popochom/ECEN404-2026SP-SolarHomeLighting1/README.md

This is a Repository that Contains the project files for a Solar-Powered Home Lighting System. 

This Repo is divided into the four main subsystems, namely:
- Charge Controller
- Power Inverter
- Sensors and Lighting Microcontroller
- Mobile App and Activity Detection Software
