popochom/ECEN404-2026SP-SolarHomeLighting1/Presentations/404/Solar Home Lighting 1 (Team 42) -  Showcase Poster.pptx

Solar Home Lighting 1
Matthew Cepulis, Corey Perlmutter, Thomas Moll, Sara Rueda
Professor Wonhyeok Jang

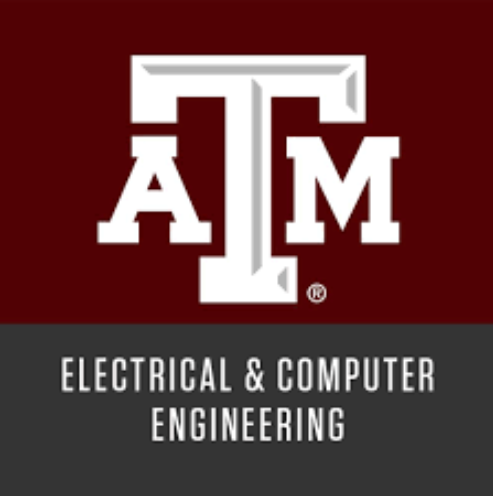
[picture p1: figure]

Problem Definition
Traditional residential lighting systems rely heavily on grid electricity, lack intelligent control features, and do not optimize for energy savings, especially for night-time usage when lighting demand is highest.

Methodology
For our project, we designed and prototyped a standalone Solar Home Lighting System that facilitates various functions. For power generation and storage, the system employs an MPPT Charge Controller to regulate the current from a solar panel to charge a 12V battery. The stored charge is then distributed to a handful of subsystems for use by the end-user, such as a 120VAC inverter for powering small electronics, a microcontroller for monitoring sensors and operating on-board lights, and a Raspberry Pi running low-light Human Detection. For monitoring and control, an app was designed that interfaces with the subsystem through a cloud database.

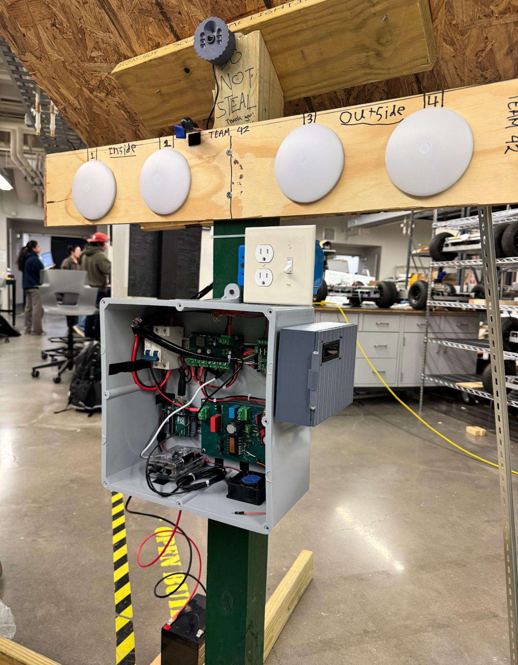
[picture p2: figure]

Figure 2. Integrated system

B

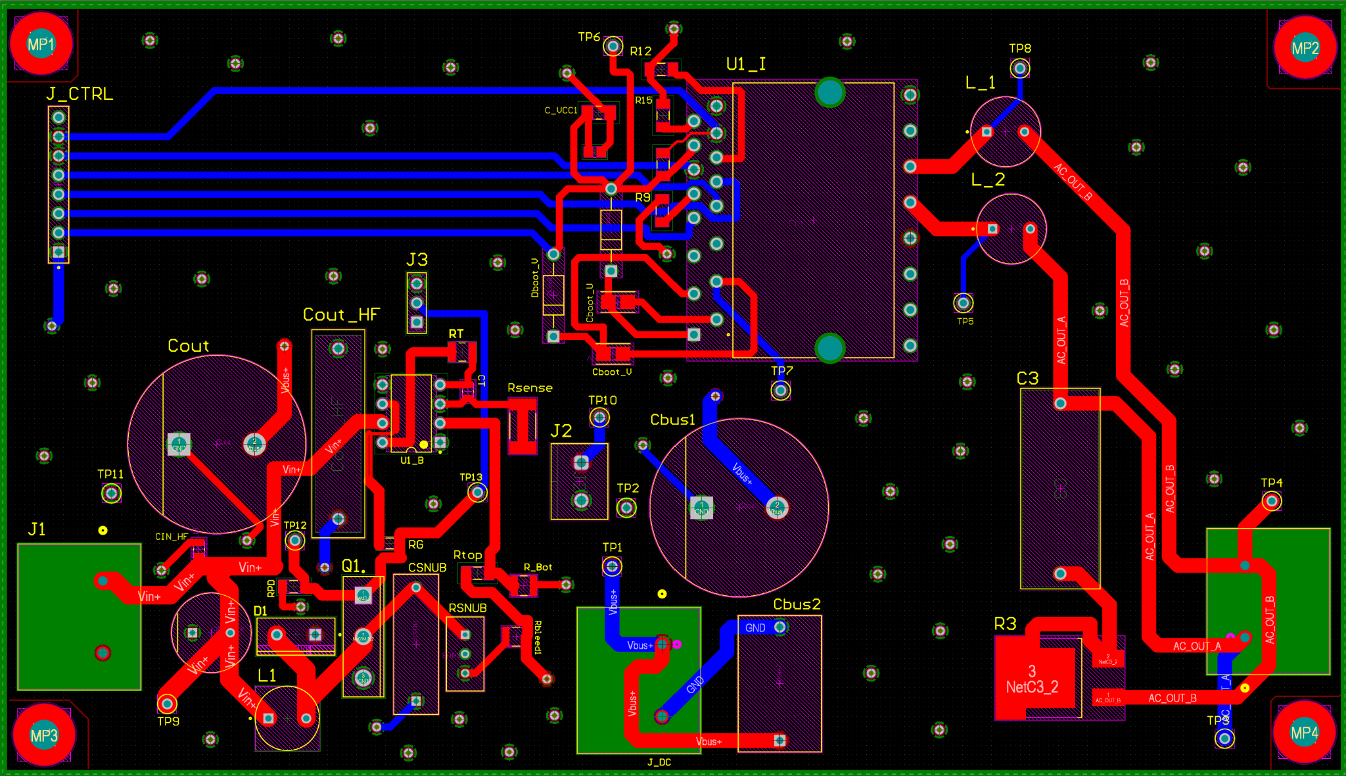
[picture p3: figure]
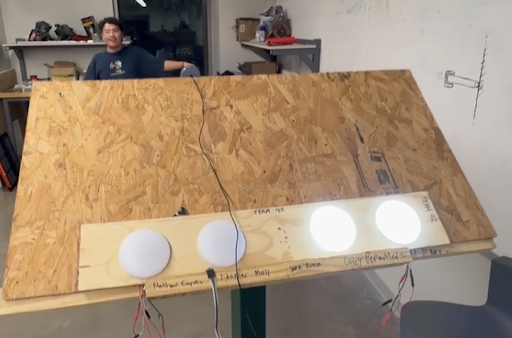
[picture p4: figure]

Figure 7. Lighting system

C

Figure 4. Boost Converter - Inverter Schematic

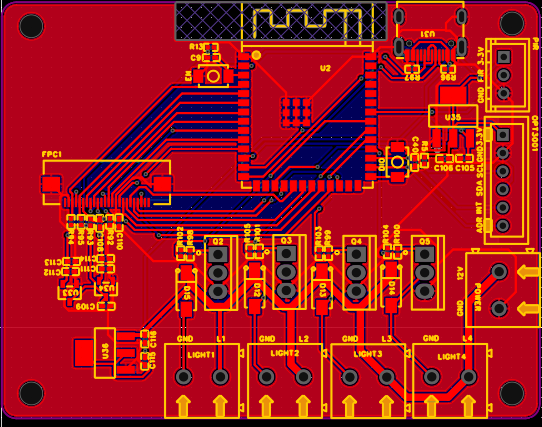
[picture p5: figure]

Figure 5. Sensor Control Schematic

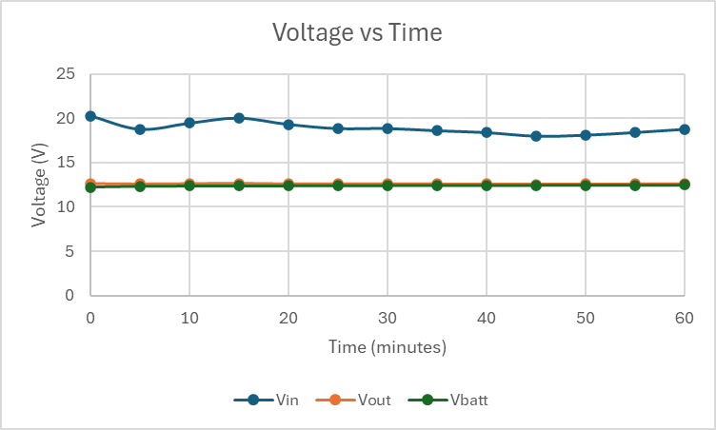
[picture p6: figure]

Engineering Analysis
The system was divided into different subsystems to simplify the design and ensure proper integration. Each subsystem handles a specific function and works together to achieve the overall system performance.
  A. Solar panel and charge controller subsystem
  B. DC/AC load subsystem
  C. Microcontroller and sensor data subsystem
  D. Mobile application and image processing subsystem

D

Figure 8. Charging Data

Impact
  - Intelligent Autonomous Lighting: Sensors and AI detect motion and ambient light, turning lights on only when needed at night to reduce energy use.
  - Sustainable Off-Grid Power: Solar panels and battery storage allow the system to operate independently from the grid, providing reliable nighttime lighting.
  - Remote Monitoring and Control: A mobile app with cloud integration lets users monitor and control lighting in real time, with both manual and automatic modes.

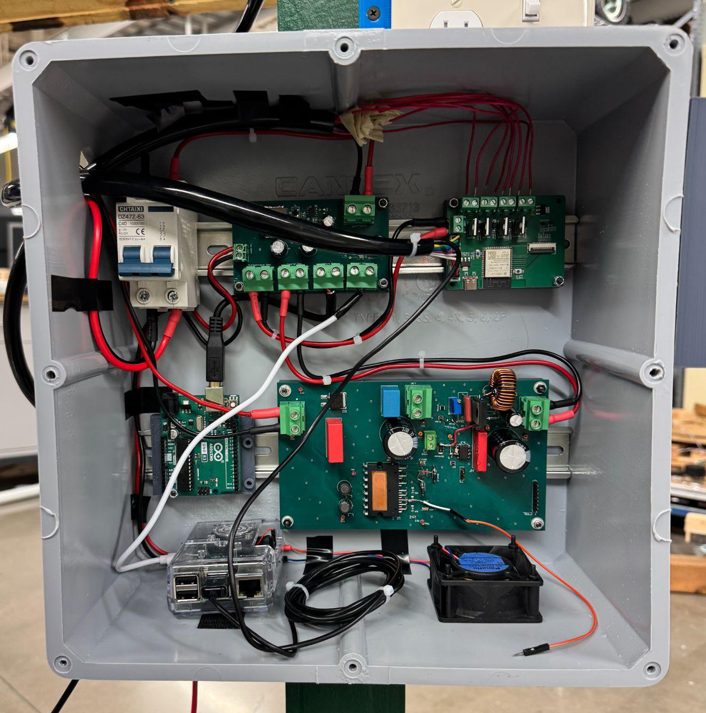
[picture p7: figure]

Figure 1. Integrated system

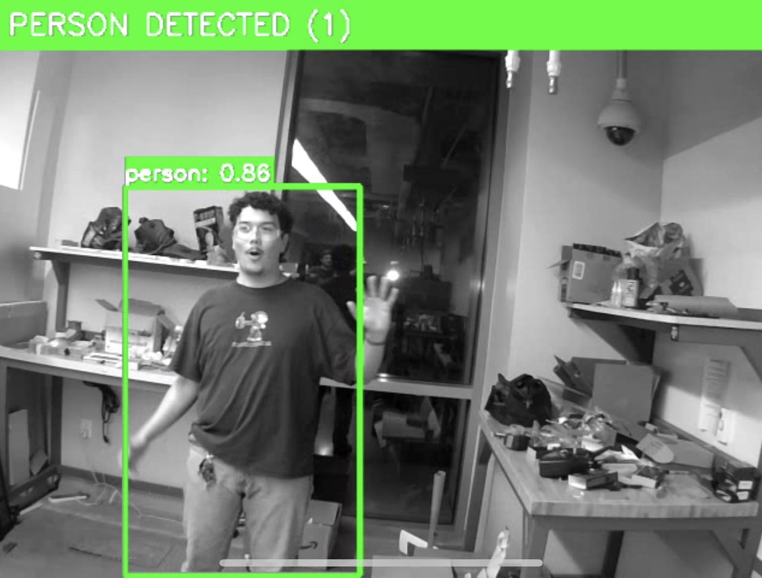
[picture p8: figure]

Figure 6. Human Detection in action.

Outcomes
The Solar Home Lighting system successfully integrated four subsystems; solar charge control, DC/AC power conversion, microcontroller sensor fusion, and mobile app control, into a functional off-grid residential lighting platform. Together the subsystems demonstrate a deployable, grid-independent lighting solution that reduces energy waste through intelligent occupancy-based automation.

A

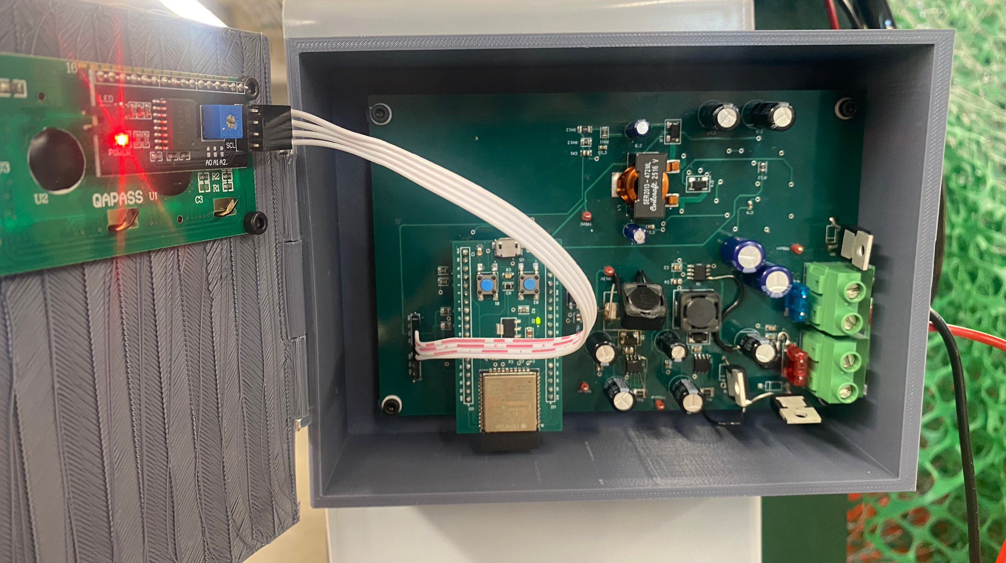
[picture p9: figure]

Figure 3. Charge Controller

References
1. Morawski, I., Chen, Y. A., Lin, Y. S., & Hsu, W. H. (2021). Nod: Taking a closer look at detection under extreme low-light conditions with night object detection dataset. arXiv preprint arXiv:2110.10364.

Acknowledgements
We would like to thank our professors and teaching assistants for their guidance and support throughout this project, as well as Texas A&M University for providing the resources that made this work possible.
