popochom/ECEN404-2026SP-SolarHomeLighting1/Sensors and Lighting/BOM_Board1_PCB1_2026-02-12.xlsx

No. | Quantity | Comment | Designator | Footprint | Value | Manufacturer Part | Manufacturer | Supplier Part | Supplier
1 | 5 | 100nF | C9,C40,C108,C113,C114 | C0402_NEW |  | CL05B104KO5NNNC | SAMSUNG | C1525 | LCSC
2 | 4 | 1uF | C105,C106,C115,C116 | C0402 | 1uF | CL05A105KP5NNNC | SAMSUNG(三星) | C14445 | LCSC
3 | 3 | 10uF | C109,C111,C112 | C0402 | 10uF | CL05A106MP5NUNC | SAMSUNG(三星) | C315248 | LCSC
4 | 1 | 15pF | C110 | C0402 | 15pF | CL05C150JB5NNNC | SAMSUNG(三星) | C86285 | LCSC
5 | 4 | SS54 | D12,D13,D14,D15 | SMA_L4.4-W2.8-LS5.4-R-RD |  | SS54 | MDD(辰达半导体) | C22452 | LCSC
6 | 2 | TS-1071AS-A1B3-D4 | DIO,EN | SW-SMD_L4.0-W3.0-LS4.8 |  | TS-1071AS-A1B3-D4 | Yuandi(元迪) | C492861 | LCSC
7 | 1 | OV2640 | FPC1 | FPC-SMD_P0.50-24P_XJ-FGS |  |  |  | C132514
8 | 5 | WJ500V-5.08-2P | LIGHT1,LIGHT2,LIGHT3,LIGHT4,POWER | CONN-TH_2P-P5.00_WJ500V-5.08-2P |  | WJ500V-5.08-2P | KANGNEX(康奈克斯电气) | C8465 | LCSC
9 | 1 | HX-XH2.54-6PZZ | OPT3001 | CONN-TH_6P-P2.50_BX-XH2.54-6PZZ |  | HX-XH2.54-6PZZ | hanxia(韩下) | C42391664 | LCSC
10 | 1 | HX-XH2.54-3PZZ | PIR | CONN-TH_3P-P2.50_HC-XH-3A-G |  | HX-XH2.54-3PZZ | hanxia(韩下) | C42391661 | LCSC
11 | 4 | IRL540NPBF | Q2,Q3,Q4,Q5 | TO-220-3_L10.0-W4.5-P2.54-T |  | IRL540NPBF | Infineon(英飞凌) | C111607 | LCSC
12 | 9 | 10kΩ | R5,R13,R93,R94,R95,R98,R99,R100,R101 | R0402 |  | 0402WGF1002TCE | UniOhm | C25744 | LCSC
13 | 1 | 1kΩ | R92 | R0402 | 1kΩ | 0402WGF1001TCE | UNI-ROYAL(厚声) | C11702 | LCSC
14 | 2 | 5.1kΩ | R96,R97 | R0402 | 5.1kΩ | 0402WGF5101TCE | UNI-ROYAL(厚声) | C25905 | LCSC
15 | 4 | 330Ω | R102,R103,R104,R105 | R0402 | 330Ω | RC0402FR-07330RL | YAGEO(国巨) | C105875 | LCSC
16 | 1 | ESP32-S3-WROOM-1-N16 | U2 | WIRELM-SMD_ESP32-S3-WROOM-1 |  | ESP32-S3-WROOM-1-N16 | ESPRESSIF(乐鑫) | C2913199 | LCSC
17 | 1 | BX-TYPE-C-C-MWT16P | U31 | USB-C-SMD_BX-TYPE-C-C-MWT16P |  | BX-TYPE-C-C-MWT16P | Bossie(博锡) | C18077665 | LCSC
18 | 1 | XC6206-2.8V | U33 | SOT-23-3_L2.9-W1.6-P1.90-LS2.8-BR |  | XC6206-2.8V | YONGYUTAI(永裕泰) | C2892669 | LCSC
19 | 1 | XC6206-1.2V | U34 | SOT-23-3_L3.0-W1.6-P1.90-LS2.8-BR |  | XC6206-1.2V | YONGYUTAI(永裕泰) | C49446790 | LCSC
20 | 1 | AMS1117-3.3 | U35 | SOT-223-3_L6.5-W3.4-P2.30-LS7.0-BR |  | AMS1117-3.3 | AMS | C6186 | LCSC
21 | 1 | AMS1117-5.0 | U36 | SOT-223_L6.5-W3.5-P2.30-LS7.0-BR |  | AMS1117-5.0 | AMS | C6187 | LCSC
