popochom/ECEN404-2026SP-SolarHomeLighting1/Charge Controller/ESP32_separate/ESP32_Seperate.step

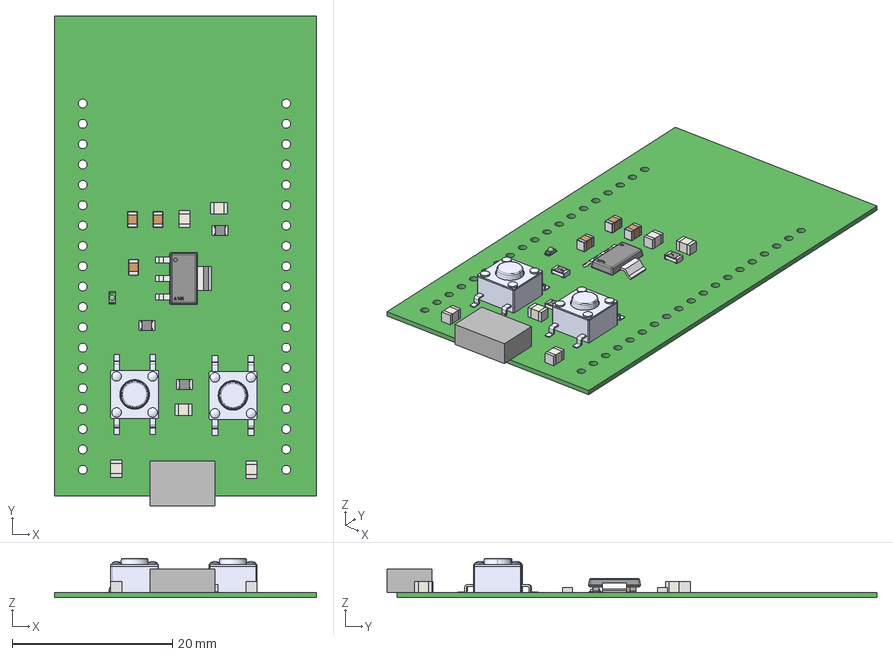
[picture p18: CAD file, 2026-04-21]
Charge Controller/ESP32_separate/ESP32_Seperate.step
32.8 x 61.2 x 4.92 mm
pins x 3
top x 3
part number x 3
Extruded x 16
color
IC_Advanced_Monolithic_Systems_ams1117_eec
Murata Logo 3 x 3
