popochom/ECEN404-2026SP-SolarHomeLighting1/Charge Controller/Supply Line/Supply Lines.step

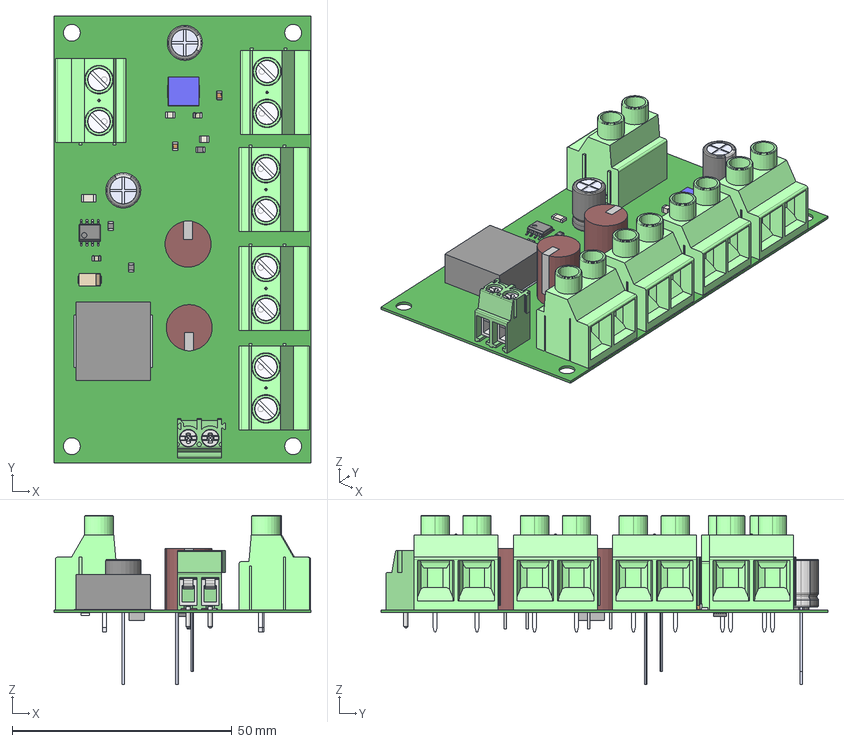
[picture p19: CAD file, 2026-04-21]
Charge Controller/Supply Line/Supply Lines.step
58.4 x 101.6 x 38.5 mm
BODY_M08A_35
LEAD_M08A_57 x 8
MANIFOLD_SOLID_BREP_2784
MANIFOLD_SOLID_BREP_2935
MANIFOLD_SOLID_BREP_3086
MANIFOLD_SOLID_BREP_3237
Extruded x 10
pins x 3
top x 4
part number x 3
terminals
logo
Pins
FilletPin1
FilletPin2
mkds_5-hv-2-9.52 x 5
CDBA-G
Cap_KEMET_C0805C472J3HAC_eec x 6
Murata Logo 3 x 2
