popochom/ECEN404-2026SP-SolarHomeLighting1/(list of files, drawings)

Other design files:
Charge Controller/ESP32_separate/3.3V_Supply.SchDoc
Charge Controller/ESP32_separate/EN_Boot_Buttons.SchDoc
Charge Controller/ESP32_separate/ESP32.PcbLib
Charge Controller/ESP32_separate/ESP32.SchLib
Charge Controller/ESP32_separate/ESP32_chip.SchDoc
Charge Controller/ESP32_separate/ESP32_Seperate.PcbDoc
Charge Controller/ESP32_separate/ESP32_Seperate.PrjPcb
Charge Controller/ESP32_separate/Main_board.SchDoc
Charge Controller/ESP32_separate/Micro_USB.SchDoc
Charge Controller/MPPT Solar Charge Controller/MPPT Solar Charge ControllerV2.PrjPcb
Charge Controller/Supply Line/5VSupply_3.5A.SchDoc
Charge Controller/Supply Line/12VSupply_1.5A.SchDoc
Charge Controller/Supply Line/Supply Lines.PcbDoc
Charge Controller/Supply Line/Supply Lines.PcbLib
Charge Controller/Supply Line/Supply Lines.PrjPcb
Charge Controller/Supply Line/Supply Lines.SchDoc
Charge Controller/Supply Line/Supply Lines.SchLib
Inverter/Final26_PCB_Project/Final26_PCB_Project.PrjPcb
Inverter/PCB_Project_Fall26.PrjPcb
Inverter/Project lib.PcbLib
Sensors and Lighting/CapstoneMCU.epro
