popochom/ECEN404-2026SP-SolarHomeLighting1/Presentations/404/Execution_Validation Plan.xlsx

Sheet: Execution Plan
Deliverables | January 14th | January 21st | January 28th | February 4th | February 11th | February 18th | February 25th | March 4th | March 18th | March 25th | April 1st | April 8th | April 15th | April 22nd
Corey Perlmutter
Rework the MPPT PCB design/Implement the new Buck-Boost Converter |  |  |  |  |  |  |  |  | Not Started
Check both PCB designs for MPPT and ESP32 |  |  |  |  |  |  |  |  | Completed
Order PCB and parts |  |  |  |  |  |  |  |  | In Progress
Solder PCB
Verify PCB
Make changes to the Charge Controller Code
Test the Charge Controller's Function (Output the required 14.6V)
Test the ESP32 Self Made Dev Kit Fucntionality
Design Power Paths from Battery
Make the PCB for Power Paths and Route
Order Power Paths Parts
Solder Power Paths PCB
Test Functionality of Power Paths
Sara Rueda
Re-route/re-design PCB
Order parts and PCB
Solder parts on PCB
Verify PCB
Validate Subsystem Functionality
Design Power Paths from Battery
Make the PCB for Power Paths and Route
Order Power Paths Parts
Solder Power Paths PCB
Test Functionality of Power Paths
Thomas Moll
Rework PCB Design
Reorder PCB and parts
Solder parts on PCB
Finalize code for sensors and lighting system
Design PCB housing and sensor mounts
Build home lightbulb housing and wiring
Matthew Cepulis
Flash Raspberry Pi 4
Test YOLO v8n on RPI4 with video
Test video upload to Firebase
Train YOLO v8n on Full NODD
Test full subsystem in lab conditions (script in venv, normal lighting, upload/download video).
Test full subsystem in expected conditions (script on Pi, at night, upload/download video).
Finalize Software Subsystem
Redesign App UI (for integration)
Team
Connect sensors ESP32 data collection to Firebase
Connect Firebase commands to ESP32 relays/switches
Connect human detection to Firebase
Integrate Data from Charge Controller with Firebase
Integrate Solar Panel, Charge Controller, and Battery
Integrate Solar Panel, Charge Controller, Power Paths, and Battery
Integrate Charge Controller and DC/AC subsystems
Test Integration Functionality
Finalize Integration
Design House Mock-Up
Build House Mock-Up
Prepare for Demo (trial runs)
Demo

Sheet: Validation Plan
Tests | Detail | Data | Status
Solar Panel and Charge Controller Subsystem
Continuity Charge Controller and ESP32 PCBs | There are no shorts on the board, and all nets are connected | N/A | Pass
12 V T1 | The supply line provides 12V with varying input and draws. | Varying input → 12V | Pass
3.3V T2 | The supply line provides 3.3V with varying input and draws. | Varying input → 3.3V | Pass
5V T3 | The supply line provides 5V with varying input and draws. | Varying input → 5V | Pass
LCD T4 | The display cycles through all displays and shows the correct info. | All 5 Displays Output Correct Info | Pass
D&S T5 | All sensors are reading the correct information and displaying it on the display and via the wireless connection. | Vin → 17V, Iout → 3A, Vout → 14.6V, Pout → 94 W, SoC → varies | Pass
PWM T6 | Shows that the external DAC can regulate the output voltage for appropriate level for charging. | Vout → 14.6V, Vset/VDAC → 0 - 3.3V | Pass
DCL T7 | The charge controller can operate under a load and produce the correct output voltage. | Vout → 14.6V, Idraw → 0.5A | Pass
Batt T8 | The charge controller can operate with a battery plugged in and safely charge and maintain it. | Vin → 17V, Iin → 5.89A, Vout → 14.6V, Pout → 50 W, Idraw → 3.6A, SoC → varies | Pass
Panel T9 | The charge controller can operate with the panel plugged in and maitains power to the chagre controller keeping functionality | Vin → 17V, Iin → 5.89A, ESP32 → on, Display → on, 12V Supply → 12V, 3.3V Supply → 3.3V, 5V Supply → 5V | Pass
Continuity Power Paths from Battery | There are no shorts on the board, and all nets are connected | N/A | Pass
Batt2 T10 | Microcontroller gets proper power and current battery | Batt/Vin → 12V, Vout → 12V, | Pass
Batt3 T11 | RaspberryPi gets proper power and current from battery | Batt/Vin → 12V, Vout → 5V, Iout → 3A | Pass
Batt4 T11 | Inverter gets proper power from the battery | Batt/Vin → 12V | Pass
DC/AC Load (Inverter) Subsystem
PCB continuity | No shorts on the board; critical nets are properly connected. | N/A | Pass
Test B1 | Boost converter increase the input voltage to 120V. | J1→12V, 0.1A and J_DC→ 120V | Fail
Test B1.1 | Boost converter increase the input voltage above 12 V. | J1→12V, 0.1A and J_DC→ >12V | Pass
Test B2 | Input voltage reaches the boost stage. | Vin=12V, Vbus (Cbus1 and Cout_HF)=12V, Iin=0.1A | Pass
Test B3 | Boost stage input responds correctly; no short or overcurrent at startup. | 0 - 12V ramp | Pass
Test B4 | Boost controller IC is powered, switching and boosting. | VDD (U1_B) = 12V | Pass
Test I1 | Inverter stage and gate driver operate correctly when supplied with proper VDD and DC bus. | Using 15V→no fault, and square wave (U output) | Pass
Test I2 | LC filter outputs | Filtered output | Pass
Test F1 | Providing correct VDD and DC bus removes fault conditions; confirms inverter protection circuitry functions normally. | VFO = OK | Pass
Microcontroller and Sensor Data Subsystem
PCB continuity | No shorts on the board; critical nets are properly connected. | N/A | Pass
Motion Sensor Test | Motion Sensor functions correctly and outputs data | Outputs detection to COM4 terminal | Pass
Light sensor Test | Light Sensor functions correctly and outputs data | Outputs detection to COM4 terminal | Pass
Camera Test | Camera functions correctly and outputs data | Outputs feed to a test website | Pass
Light Test | Mosfets trigger light terminals via ESP32 | 12V on terminals when off, 0V when on | Pass
Firebase Upload test | ESP32 connects to firebase database and can send data | N/A | Pass
Mobile Application and Image Processing Subsystem
App -> Firebase | Full App Functionality with firebase | read/write data, create/store new accounts, etc. | Pass
CNN Detection | CNN Can detect human activity in low light environments. | - | Pass
CNN False Positives | CNN does not make any false positive hits on cars, bikes, etc. | Zero False Positives in testing | Pass
CNN -> RPi4 | Python script works automatically on Raspberry Pi | Works on pi, low-no light detections have 65%+ conf. | Pass
Frame Rate On RPi4 | Target Frame Rate of 10 FPS, minimum 1 FPS. | 3.5 fps | Pass
CNN Script -> Firebase Database | python script can talk to Firebase, read/write data. | connection to FB good, can send/recieve relevant data. | Pass
CNN Script -> Video Upload | python script can successfully upload video. | uploads time-stamped clip to FB storage | Pass
Project
Battery to Inverter Connection | Expected input going into the inverter from the battery | 12V into inverter | Pass
Inverter to outlet | Check the output to make sure it can power 2 lamps and charge one smartphone | 0.5A RMS → 15W (one lamp) | Pass
App -> Firebase -> Light Controls | Inputs on the mobile app control the switches that activate the lights. | N/A | Pass
Sensor Data | Sensor data is processed by the Firebase and can be accessed by the mobile app | Temperature, ... | Pass
Power Data | Power data is processed by the Firebase and can be accessed by the mobile app | Generation, Battery Capacity, Usage | Pass
Readings Packets | Readings are stored in the 'readings' area and display correctly to Graphs | N/A | Pass
Solar Panel to Battery Charging | Check that under sunlight the battery charges as expected and log charging current | N/A | Pass
Solar Panel to Battery 14.6V | When the battery is at a low charge, it gets charged at 14.6V during the day | Vin →17V, Vout → 14.6V | Fail
Solar Panel to Battery 13.6V | When the battery is at a medium to close to full charge, it gets charged at 13.6V during the day | Vin →17V, Vout → 13.6V | Pass
Solar Panel to Battery 12.5V / Regulate | When the battery is at a full charge, it gets charged at 12.5V during the day, as to regulate the battery and not overcharge it | Vin →17V, Vout → 12.5V | Pass
Solar Panel to Battery 0V (No Sun) | When No to little sunlight the battery is only discharging, display values SOC at -1 meaning discharging | Vin →0V, Vout → 0V, Battery Voltage to Supply → 12V | Pass
Solar Panel to Battery During Cloudy Conditions | When there is cloudy conditions outside the battery should discharge, unless the panel is able to provide enough voltage to charge | Vin →Low , Vout → 0V, Battery Voltage to Supply → 12V (Cloudy), Vin →17V, Vout → 12.5V (Enough Solar Input) | Pass
Battery to Loads | Battery can supply power to loads/ Inverter, Microcontroller, and Pi for extended period of time | Batt/Vin → 12V, Vout,inv → 12V, Vout,Pi → 5V, Vout,micro →12V | Pass
Battery endurance test | Discharge the battery via inverter and measure how long it powers the load | N/A | Pass
System Safety | Test that overvoltage or short circuit protection works and the system shuts down safely | N/A | Pass
Latency Test | Measure the delay between app command and light response | N/A | Pass
Supply lines - Full load on lab supply | Measure the current draw of the supply line to measure base system power draw |  | Pass
Supply lines - Full load on battery | Verify that the battery can support base system power draw |  | Pass
Lighting control using battery | Determine that lights and MCU system work with the battery instead of the lab supply. | Vin = 12V, lights toggle | Pass
Motion/Human Activity Lighting Control | Determine that lights toggle with the presence/absence of motion and/or human activity |  | Pass
