popochom/ECEN404-2026SP-SolarHomeLighting1/(commit log)

2026-04-20 charge controlle file
2026-04-20 sensors and lighting folder
